becblue/H2_transmitter_PCB/3D图纸/导轨支架.png

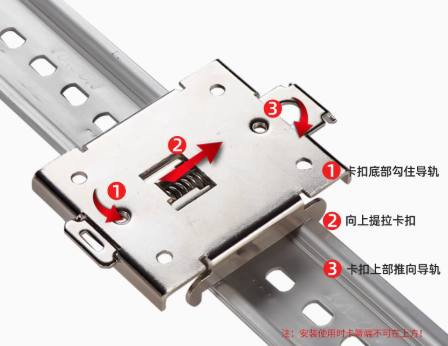
3D图纸/导轨支架.png
