becblue/H2_transmitter_PCB/壳体开孔图纸.png

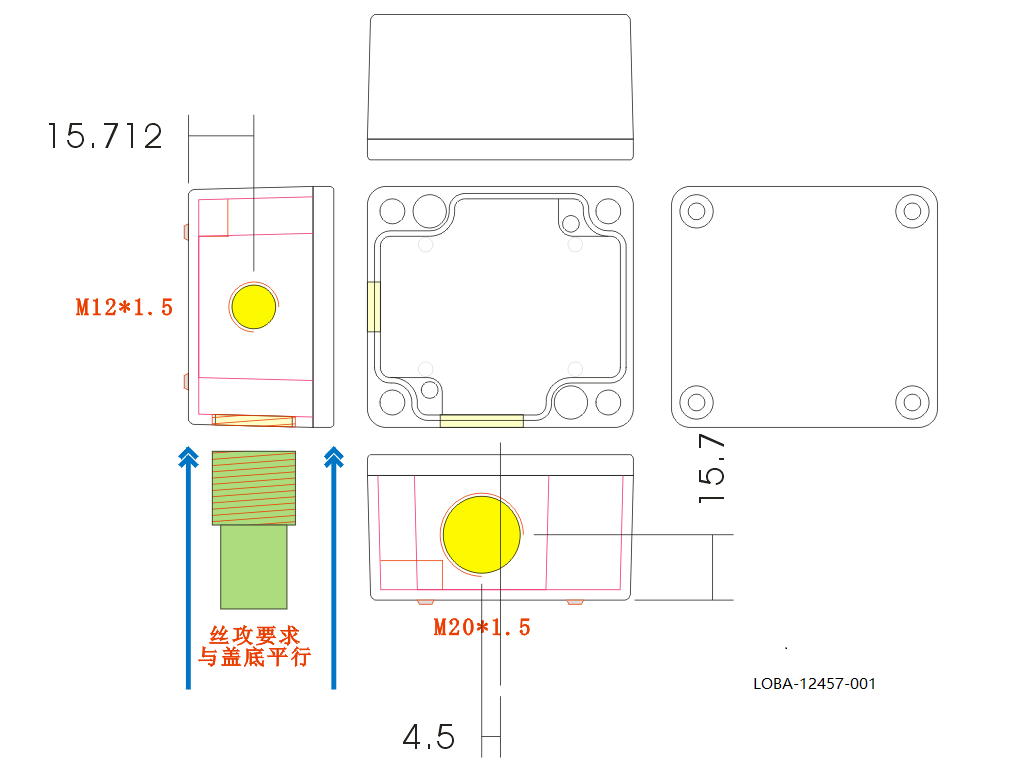
壳体开孔图纸.png
