becblue/H2_transmitter_PCB/PCB文件/嘉立创新建项目/氢气传感器（已标定）模块电路/BOM_Board1_PCB1_2025-02-27_v4.xlsx

Sheet: BOM_Board1_Schematic1_2025-02-2
No. | Quantity | Comment | Designator | Footprint | Value | Manufacturer Part | Manufacturer | Supplier Part | Supplier
1 | 4 | 100nF | C1,C5,C9,C11 | C0402 | 100nF | CC0402KRX7R9BB104 | YAGEO(国巨) | C131394 | LCSC
2 | 4 | 22uF | C2,C3,C12,C13 | C0805 | 22uF | CC0805MKX5R8BB226 | YAGEO(国巨) | C784585 | LCSC
3 | 4 | 10uF | C4,C10,C14,C15 | C0603 | 10uF | GRM188R6YA106MA73D | muRata(村田) | C194427 | LCSC
4 | 1 | 47uF | C6 | CAP-SMD_L7.3-W4.3-FD | 47uF | T491X476K035AT | KEMET(基美) | C87110 | LCSC
5 | 1 | 75pF | C7 | C0402 | 75pF | CC0402JRNPO9BN750 | YAGEO(国巨) | C107010 | LCSC
6 | 2 | 10uF | C8,C17 | CASE-C_6032 | 10uF | TAJC106K035RNJ | Kyocera AVX | C7211 | LCSC
7 | 1 | 100pF | C16 | C0402 | 100pF | CC0402KRX7R8BB101 | YAGEO(国巨) | C541383 | LCSC
8 | 1 | 10uF | C18 | C0603 | 10uF | HGC0603R5106M350NTHJ | Chinocera(华瓷) | C22367827 | LCSC
9 | 2 | 1nF | C19,C20 | C0603 | 1nF | CC0603KRX7R9BB102 | YAGEO(国巨) | C100040 | LCSC
10 | 1 | SS14 | D1 | SMA_L4.2-W2.6-LS5.3-RD |  | SS14 | MDD(辰达半导体) | C2480 | LCSC
11 | 1 | SMCJ24CAX | D2 | SMC_L6.9-W5.9-LS7.9-BI |  | SMCJ24CAX | 晶扬电子 | C3038088 | LCSC
12 | 2 | SS14 | D3,D4 | SMA_L4.3-W2.6-LS5.2-RD |  | SS14 | onsemi(安森美) | C83852 | LCSC
13 | 1 | SMBJ36CA | D5 | SMB_L4.6-W3.6-LS5.4-RD |  | SMBJ36CA | 宏嘉诚 | C19077589 | LCSC
14 | 1 | SMBJ12CA | D6 | SMB_L4.6-W3.6-LS5.4-RD |  | SMBJ12CA | 宏迦橙 | C19077566 | LCSC
15 | 2 | M7 | D7,D8 | SMA_L4.3-W2.6-LS5.0-FD |  | M7 | 宏迦橙 | C7420350 | LCSC
16 | 1 | 1N4148W | D9 | SOD-123_L2.7-W1.6-LS3.7-FD |  | 1N4148W | 宏迦橙 | C7420318 | LCSC
17 | 1 | BSMD1812-050-30V | F1 | F1812 |  | BSMD1812-050-30V | BHFUSE(佰宏) | C883141 | LCSC
18 | 1 | 10uH | L1 | IND-SMD_L4.4-W4.2 | 10uH | FXL0420-100-M | cjiang(长江微电) | C177242 | LCSC
19 | 1 | 4.7uH | L2 | IND-SMD_L7.0-W6.6 | 4.7uH | FXL0630-4R7-M | cjiang(长江微电) | C167220 | LCSC
20 | 1 | 15uH | L3 | IND-SMD_L4.0-W4.0 | 15uH | FHD4020S-150MT | cjiang(长江微电) | C602033 | LCSC
21 | 1 | SK2301AA | Q1 | SOT-23-3_L2.9-W1.6-P1.90-LS2.8-BR |  | SK2301AA | SHIKUES(时科) | C118316 | LCSC
22 | 1 | SS8050 | Q2 | SOT-23-3_L2.9-W1.3-P1.90-LS2.4-BR |  | SS8050 | 宏迦橙 | C7420370 | LCSC
23 | 2 | 49.9Ω | R1,R6 | R0402 | 49.9Ω | PTFR0402B49R9P9 | RESI(开步睿思) | C478876 | LCSC
24 | 2 | 511kΩ | R2,R7 | R0603 | 511kΩ | ARG03BTC5113 | Viking(光颉) | C2684557 | LCSC
25 | 2 | 105kΩ | R3,R12 | R0402 | 105kΩ | RT0402BRD07105KL | YAGEO(国巨) | C852475 | LCSC
26 | 3 | 100kΩ | R4,R10,R11 | R0402 | 100kΩ | RT0402BRD07100KL | YAGEO(国巨) | C852472 | LCSC
27 | 1 | 13.3kΩ | R5 | R0603 | 13.3kΩ | RT0603BRD0713K3L | YAGEO(国巨) | C861117 | LCSC
28 | 2 | 27kΩ | R8,R15 | R0603 | 27kΩ | RT0603BRE0727KL | YAGEO(国巨) | C326751 | LCSC
29 | 2 | 2kΩ | R9,R26 | R0603 | 2kΩ | RT0603BRD072KL | YAGEO(国巨) | C728588 | LCSC
30 | 1 | 5.23kΩ | R13 | R0603 | 5.23kΩ | RT0603BRD075K23L | YAGEO(国巨) | C861485 | LCSC
31 | 3 | 10kΩ | R14,R20,R25 | R0603 | 10kΩ | RT0603BRD0710KL | YAGEO(国巨) | C95204 | LCSC
32 | 2 | 0Ω | R16,R24 | R0603 | 0Ω | RC0603FR-070RL | YAGEO(国巨) | C100044 | LCSC
33 | 1 | 100kΩ | R17 | R0603 | 100kΩ | RT0603BRD07100KL | YAGEO(国巨) | C122538 | LCSC
34 | 2 | 47Ω | R18,R19 | R0603 | 47Ω | RT0603BRE0747RL | YAGEO(国巨) | C705861 | LCSC
35 | 1 | 470Ω | R21 | R0603 | 470Ω | AR03BTC4700 | Viking(光颉) | C374403 | LCSC
36 | 2 | 200Ω | R22,R23 | R0603 | 200Ω | RT0603BRD07200RL | YAGEO(国巨) | C861216 | LCSC
37 | 2 | M4螺丝 | SCREW1,SCREW2 | M4螺丝
38 | 2 | TPS54302DDCR | U1,U2 | SOT-23-6_L2.9-W1.6-P0.95-LS2.8-BL |  | TPS54302DDCR | TI(德州仪器) | C311983 | LCSC
39 | 1 | MP2359DJ-LF-Z | U3 | SOT-23-6_L2.9-W1.6-P0.95-LS2.8-BR |  | MP2359DJ-LF-Z | MPS(芯源) | C14259 | LCSC
40 | 1 | TP2274-SR | U4 | SOIC-14_L8.7-W3.9-P1.27-LS6.0-BL |  | TP2274-SR | 3PEAK | C95870 | LCSC
41 | 1 | LZ8V-2.54-6P | U5 | LC8+LZ8V-2.54 5PIN
42 | 1 | ZX-XH2.54-5PZZ | U6 | CONN-TH_5P-P2.50_ZX-XH2.54-5PZZ |  | ZX-XH2.54-5PZZ | Megastar(兆星) | C7429635 | LCSC
43 | 1 | XY-XHB2.54-2A11 | U7 | HDR-TH_2P-P2.50-V-F-1 |  | XY-XHB2.54-2A11 | XYECONN(辛译) | C19271386 | LCSC

Sheet: Sheet1
1 | C6 | 分配立创编号 | C87110 | LCSC |  | 47uF | CAP-SMD_L7.3-W4.3-FD | 1 | T491X476K035AT | KEMET(基美) | ...
 | 2 | C7 | 分配立创编号 | C107010 | LCSC |  | 75pF | C0402 | 1 | CC0402JRNPO9BN750 | YAGEO(国巨) | ...
 | 3 | C1, | 分配立创编号 | C131394 | LCSC |  | 100nF | C0402 | 4 | CC0402KRX7R9BB104 | YAGEO(国巨) | ...
 |  | C5,
 |  | C9,
 |  | C11
 | 4 | C2, | 分配立创编号 | C784585 | LCSC |  | 22uF | C0805 | 4 | CC0805MKX5R8BB226 | YAGEO(国巨) | ...
 |  | C3,
 |  | C12,
 |  | C13
 | 5 | C4, | 分配立创编号 | C194427 | LCSC |  | 10uF | C0603 | 4 | GRM188R6YA106MA73D | muRata(村田) | ...
 |  | C10,
 |  | C14,
 |  | C15
 | 6 | C16 | 分配立创编号 | C541383 | LCSC |  | 100pF | C0402 | 1 | CC0402KRX7R8BB101 | YAGEO(国巨) | ...
 | 7 | C8, | 分配立创编号 | C7211 | LCSC |  | 10uF | CASE-C_6032 | 2 | TAJC106K035RNJ | Kyocera AVX | ...
 |  | C17
 | 8 | C18 | 分配立创编号 | C22367827 | LCSC |  | 10uF | C0603 | 1 | HGC0603R5106M350NTHJ | Chinocera(华瓷) | ...
 | 9 | C19, | 分配立创编号 | C100040 | LCSC |  | 1nF | C0603 | 2 | CC0603KRX7R9BB102 | YAGEO(国巨) | ...
 |  | C20
 | 10 | D1 | 分配立创编号 | C2480 | LCSC |  | SS14 | SMA_L4.2-W2.6-LS5.3-RD | 1 | SS14 | MDD(辰达半导体) | ...
 | 11 | D2 | 分配立创编号 | C3038088 | LCSC |  | SMCJ24CAX | SMC_L6.9-W5.9-LS7.9-BI | 1 | SMCJ24CAX | 晶扬电子 | ...
 | 12 | D3, | 分配立创编号 | C83852 | LCSC |  | SS14 | SMA_L4.3-W2.6-LS5.2-RD | 2 | SS14 | onsemi(安森美) | ...
 |  | D4
 | 13 | D5 | 分配立创编号 | C19077589 | LCSC |  | SMBJ36CA | SMB_L4.6-W3.6-LS5.4-RD | 1 | SMBJ36CA | 宏嘉诚 | ...
 | 14 | D6 | 分配立创编号 | C19077566 | LCSC |  | SMBJ12CA | SMB_L4.6-W3.6-LS5.4-RD | 1 | SMBJ12CA | 宏迦橙 | ...
 | 15 | D7, | 分配立创编号 | C7420350 | LCSC |  | M7 | SMA_L4.3-W2.6-LS5.0-FD | 2 | M7 | 宏迦橙 | ...
 |  | D8
 | 16 | D9 | 分配立创编号 | C7420318 | LCSC |  | 1N4148W | SOD-123_L2.7-W1.6-LS3.7-FD | 1 | 1N4148W | 宏迦橙 | ...
 | 17 | F1 | 分配立创编号 | C883141 | LCSC |  | BSMD1812-050-30V | F1812 | 1 | BSMD1812-050-30V | BHFUSE(佰宏) | ...
 | 18 | L1 | 分配立创编号 | C177242 | LCSC |  | 10uH | IND-SMD_L4.4-W4.2 | 1 | FXL0420-100-M | cjiang(长江微电) | ...
 | 19 | L2 | 分配立创编号 | C167220 | LCSC |  | 4.7uH | IND-SMD_L7.0-W6.6 | 1 | FXL0630-4R7-M | cjiang(长江微电) | ...
 | 20 | L3 | 分配立创编号 | C602033 | LCSC |  | 15uH | IND-SMD_L4.0-W4.0 | 1 | FHD4020S-150MT | cjiang(长江微电) | ...
 | 21 | Q1 | 分配立创编号 | C118316 | LCSC |  | SK2301AA | SOT-23-3_L2.9-W1.6-P1.90-LS2.8-BR | 1 | SK2301AA | SHIKUES(时科) | ...
 | 22 | Q2 | 分配立创编号 | C7420370 | LCSC |  | SS8050 | SOT-23-3_L2.9-W1.3-P1.90-LS2.4-BR | 1 | SS8050 | 宏迦橙 | ...
