becblue/H2_transmitter_PCB/PCB文件/DARXT/DARXT.xls

序号 | 物料名称 | 丝印 | 型号 |  | 封装 | 品牌 | 位号 | 数量 | 备注 | 正面图片 | 反面图片
1 | 贴片元器件
2 | 贴片电阻 | 103 | 10K | 5% | 0603 |  | R9 R14 R16 | 3
3 | 贴片电阻 | 104 | 100K | 5% | 0603 |  | R1 R4 R18 | 3
4 | 贴片电阻 | 201 | 200R | 5% | 0603 |  | R11 R12 | 2
5 | 贴片电阻 | 202 | 2K | 5% | 0603 |  | R6 R13 | 2
6 | 贴片电阻 | 273 | 27K | 5% | 0603 |  | R5 R15 | 2
7 | 贴片电阻 | 470 | 47R | 5% | 0603 |  | R7 R8 | 2
8 | 贴片电阻 | 471 | 470R | 5% | 0603 |  | R10 | 1
9 | 贴片电阻 | 473 | 47K | 5% | 0603 |  | R2 | 1
10 | 贴片电阻 | 912 | 9.1K | 5% | 0603 |  | R3 | 1
11 | 贴片电容 |  | 1NF | 10% | 0603 |  | C9 C10 | 2
12 | 贴片电容 |  | 100NF | 10% | 0603 |  | C1 C5 | 2
13 | 贴片电容 |  | 10UF | 20% | 1206 |  | C2 C3 C4 C6 C7 C8 | 6
14 | 一体成型电感 | 4R7 | FXL0630-4R7-M |  | 0630 | cjiang(长江微电) | L1 L2 | 2
15 | 通用二极管 | M7 | M7 |  | DO-214AC | MDD(辰达半导体) | D3 D4 | 2
16 | 肖特基二极管 | SS14 | SS14 |  | DO-214AC | MDD(辰达半导体) | D1 D7 D8 | 3
17 | 开关二极管 | T4 | 1N4148W |  | SOD-123 | 宏迦橙 | D5 | 1
18 | TVS/ESD二极管 | BE | SMBJ12CA |  | DO-214AA | 宏迦橙 | D6 | 1
19 | TVS/ESD二极管 | CP | SMBJ36CA |  | DO-214AA | 宏迦橙 | D2 | 1
20 | NPN | J3Y | S8050 |  | SOT-23 | 宏迦橙 | Q2 | 1
21 | P-MOS | A1SHB | SK2301AA |  | SOT-23 | SHIKUES(时科) | Q1 | 1
22 | IC | TP2274 | TP2274-SR |  | SOP-14 | 3PEAK(思瑞浦) | U3 | 1
23 | IC | IF8NN | MP2359DJ-LF-Z |  | SOT23-6 | MPS(芯源) | U1 U2 | 2
24 | 插件元器件
25 | 插拔式弯针座 |  | DB2ER-5.08-4P-GN |  | SIP-4 | DORABO(地博电气) | P3 | 1
26 | 插拔式接线端子 |  | DB2EK-5.08-4P-GN-S |  | SIP-4 | DORABO(地博电气) |  | 1
27 | 测试插孔 |  | 参考实物 |  | SIP-1 |  | P2 | 5 | https://item.taobao.com/item.htm?id=781619027857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 | =DISPIMG("ID_7849768306F9491B9268AB8A7467ACBD",1)
