becblue/H2_transmitter_PCB/3D图纸/传感器插座板.step.SLDASM

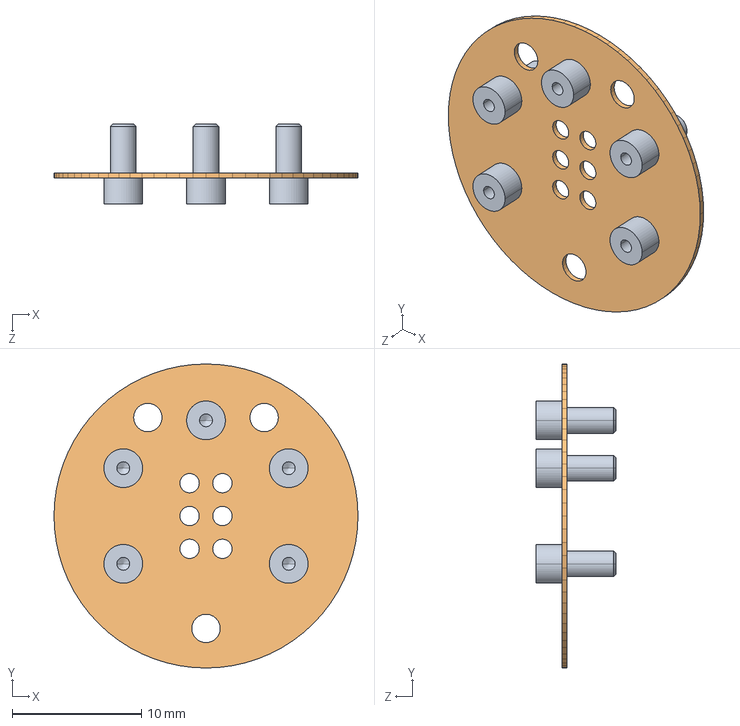
[picture p10: CAD file, 2025-04-16]
3D图纸/传感器插座板.step.SLDASM
23.5 x 23.5 x 6.20 mm
__________^JP2_传感器插座板.step x 5
Board.step
