becblue/H2_transmitter_PCB/3D图纸/气体传感器.SLDPRT

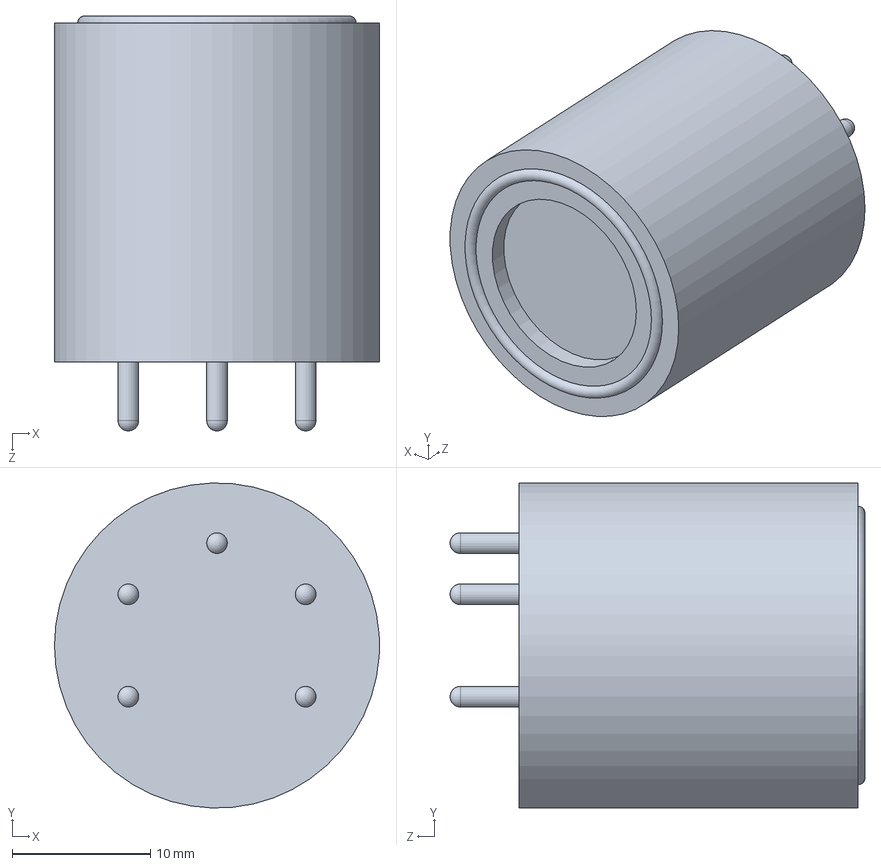
[picture p11: CAD file, 2025-04-16]
3D图纸/气体传感器.SLDPRT
23.5 x 23.5 x 30.0 mm
