becblue/H2_transmitter_PCB/PCB文件/嘉立创新建项目/氢气传感器（已标定）模块电路/DXF_PCB1_2025-02-26_AutoCAD2007.dxf

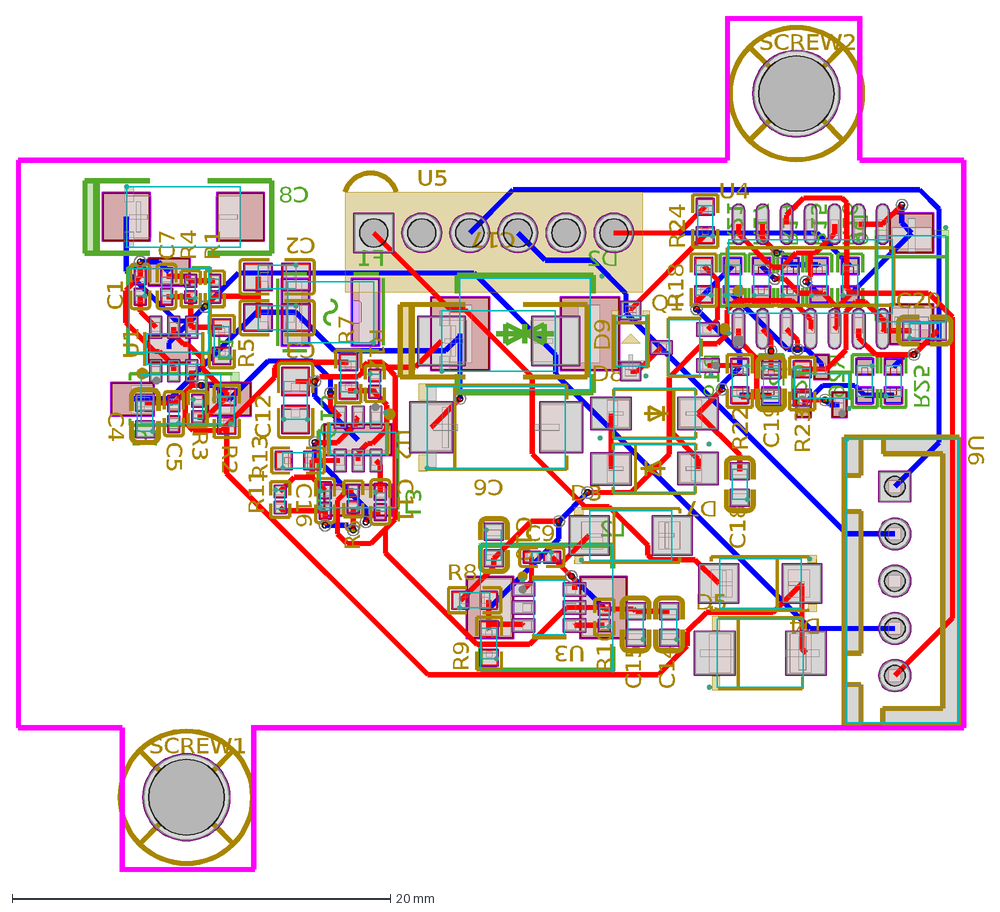
[picture p12: CAD file, 2025-04-16]
PCB文件/嘉立创新建项目/氢气传感器（已标定）模块电路/DXF_PCB1_2025-02-26_AutoCAD2007.dxf
C8
C13
D1
D2
F1
L1
L3
Q2
R19
R20
R25
R21
R26
D6
L2
R14
R15
R16
R17
C1
C2
C3
C4
C5
C6
C7
C11
C12
C16
C17
C19
C20
C18
D8
D7
D9
Q1
R1
R2
R3
R4
R5
R6
R7
R11
R12
R13
R22
R18
R23
U1
U2
U6
U5
U4
C9
C10
C14
C15
D3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
