becblue/H2_transmitter_PCB/3D图纸/传感器顶盖.SLDPRT

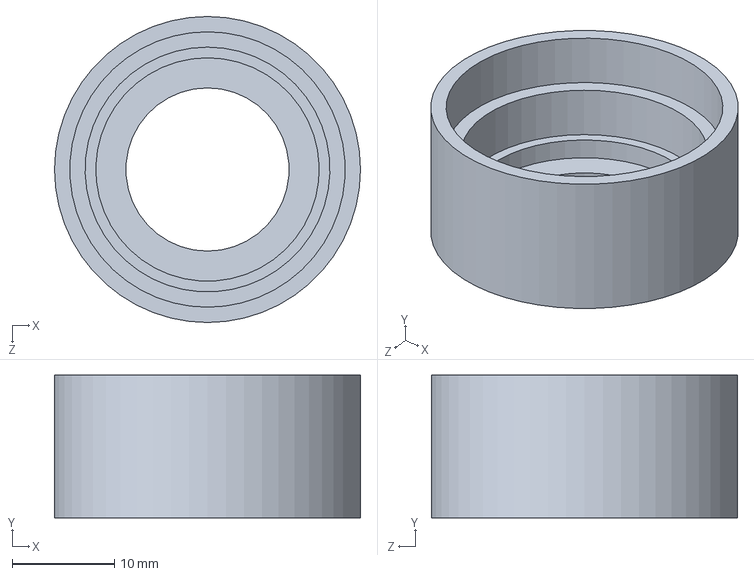
[picture p13: CAD file, 2025-04-16]
3D图纸/传感器顶盖.SLDPRT
30.0 x 14.0 x 30.0 mm
