becblue/H2_transmitter_PCB/3D图纸/六角螺柱.SLDPRT

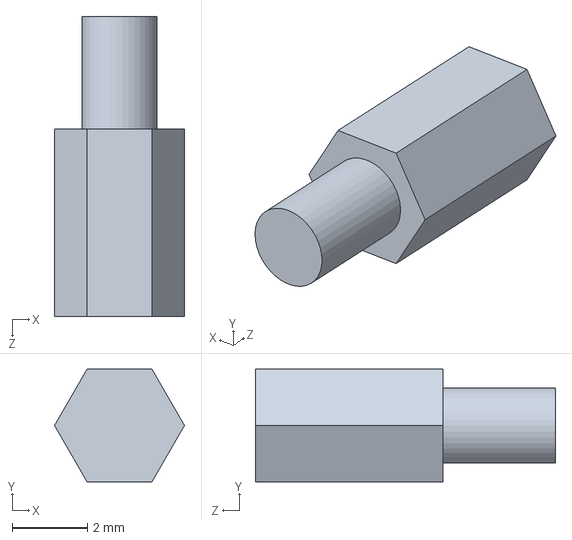
[picture p14: CAD file, 2025-04-16]
3D图纸/六角螺柱.SLDPRT
3.46 x 3.00 x 8.00 mm
