becblue/H2_transmitter_PCB/3D图纸/装配体1.STEP

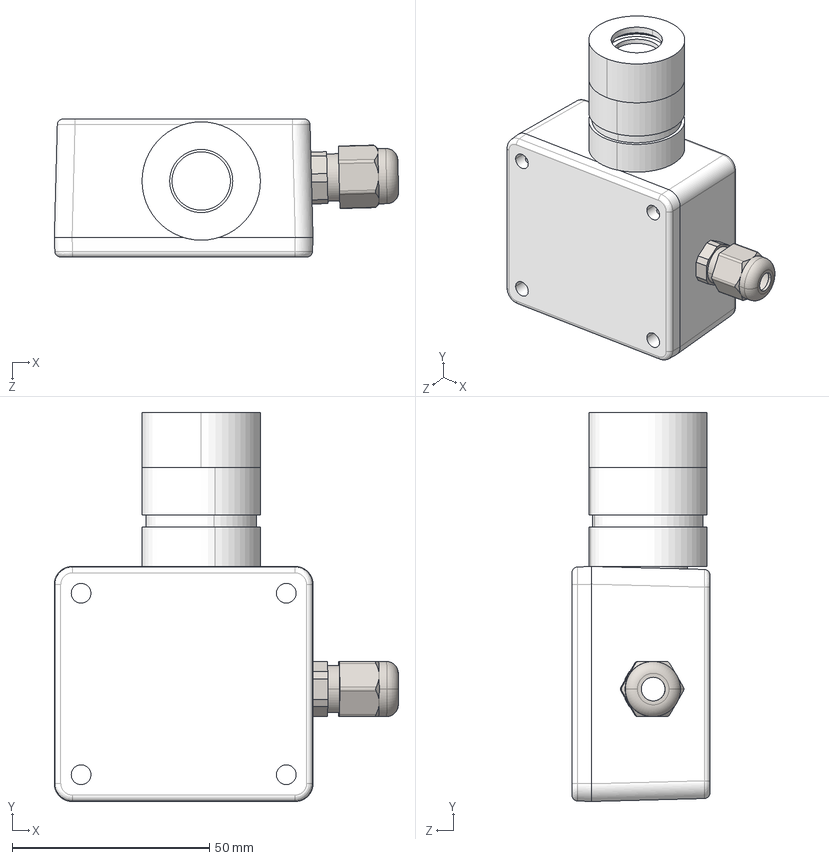
[picture p15: CAD file, 2025-04-16]
3D图纸/装配体1.STEP
87.3 x 98.6 x 35.0 mm
褲极
ァ极換覜ん
奻裔
传感器顶盖
传感器外壳
M12
