becblue/H2_transmitter_PCB/3D图纸/标定探头.SLDPRT

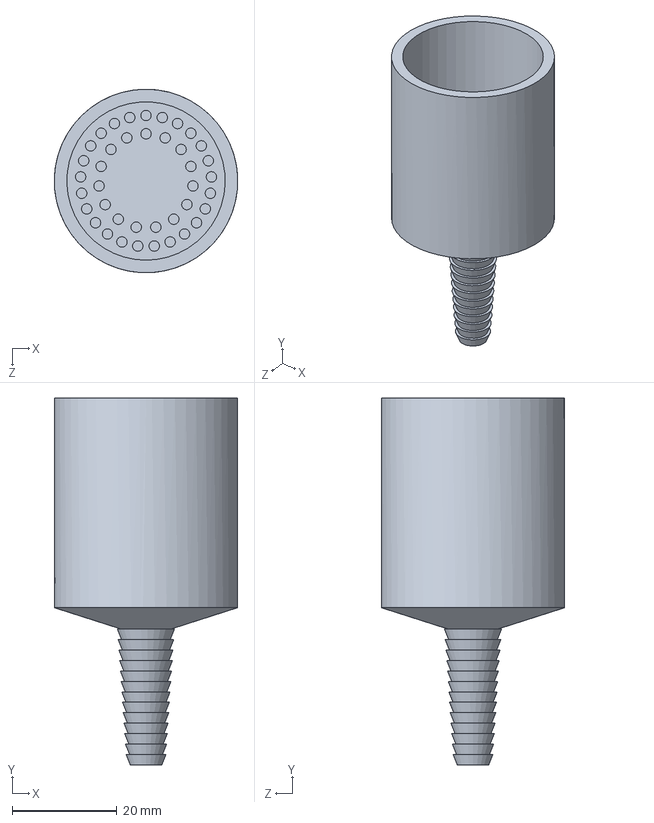
[picture p16: CAD file, 2025-04-16]
3D图纸/标定探头.SLDPRT
35.0 x 70.0 x 35.0 mm
