becblue/H2_transmitter_PCB/3D图纸/壳体.STEP

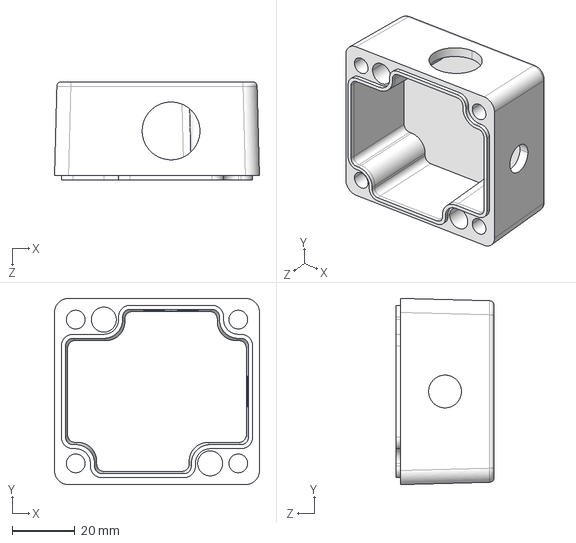
[picture p17: CAD file, 2025-04-16]
3D图纸/壳体.STEP
65.6 x 59.6 x 31.5 mm
