becblue/H2_transmitter_PCB/3D图纸/上盖.SLDPRT

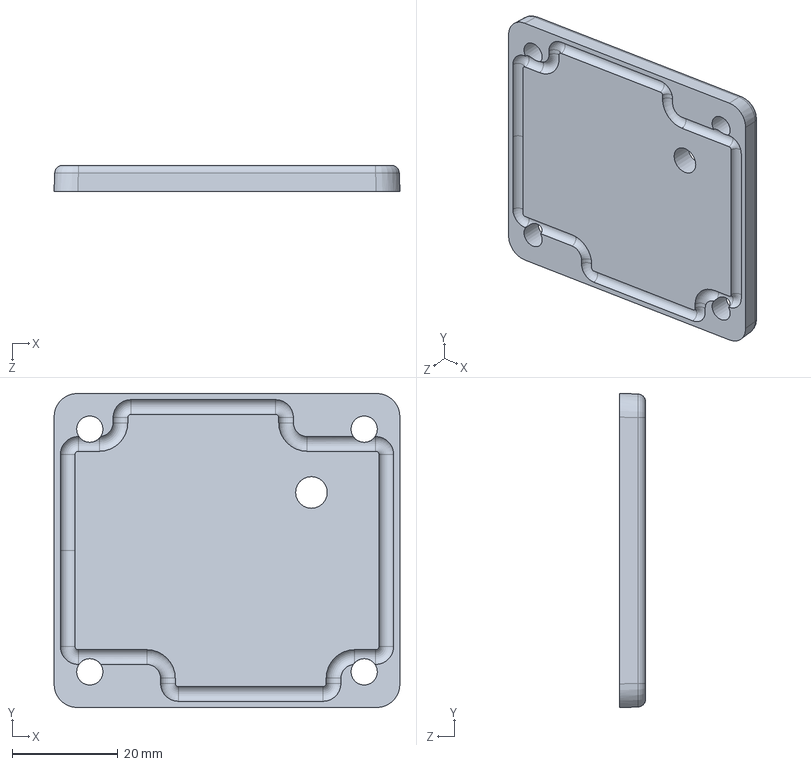
[picture p18: CAD file, 2025-04-16]
3D图纸/上盖.SLDPRT
65.6 x 59.6 x 5.00 mm
