becblue/H2_transmitter_PCB/3D图纸/传感器插座.STEP

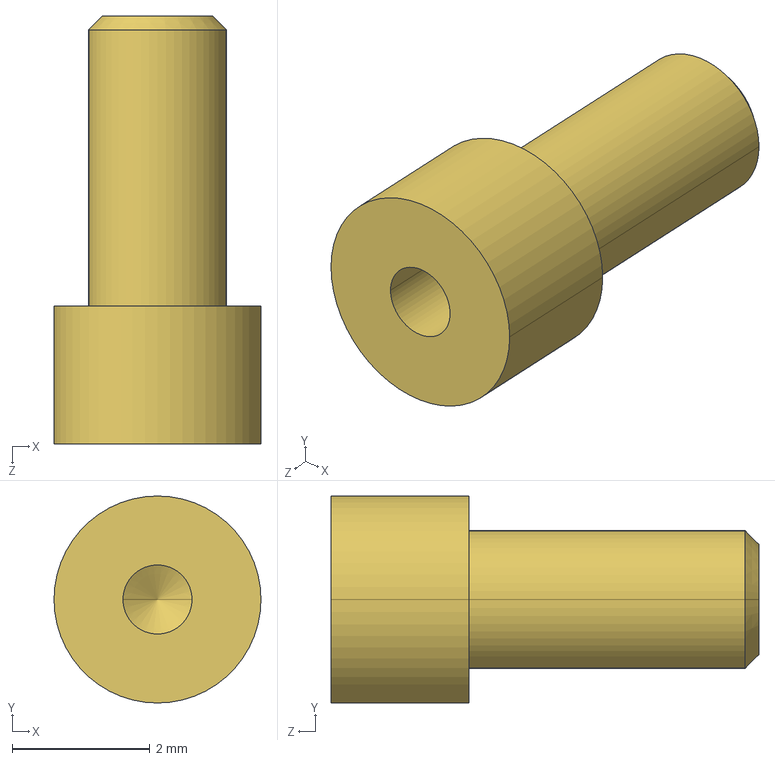
[picture p19: CAD file, 2025-04-16]
3D图纸/传感器插座.STEP
3.00 x 3.00 x 6.20 mm
