becblue/H2_transmitter_PCB/3D图纸/传感器外壳.SLDPRT

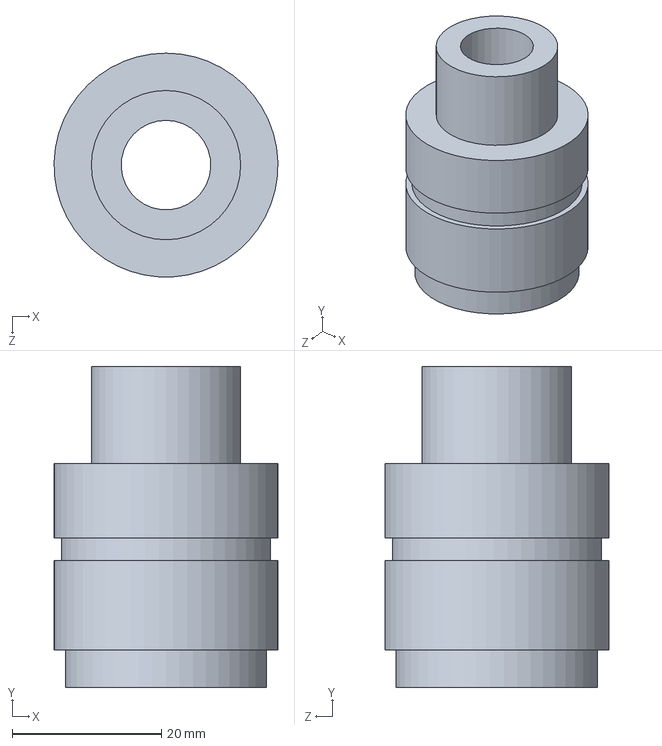
[picture p20: CAD file, 2025-04-16]
3D图纸/传感器外壳.SLDPRT
30.0 x 43.0 x 30.0 mm
