becblue/H2_transmitter_PCB/(list of files, cad)

Other CAD files:
3D图纸/传感器插座板/JP2.step.SLDASM
3D图纸/Board.step.SLDPRT
3D图纸/传感器插座板/传感器插座板.step
3D图纸/传感器插座板/__________.step.SLDPRT
3D图纸/传感器电路板.DWG
3D图纸/FA1底(1).dwg
3D图纸/NVXH-TopTrack.SLDPRT
3D图纸/上盖丝印.DWG
3D图纸/FA1盖(1).dwg
3D图纸/NVXH-TopTrack.STL
3D图纸/传感器插座.SLDPRT
3D图纸/传感器插座板/传感器插座板.SLDASM
3D图纸/壳体.SLDPRT
3D图纸/标定探头.STL
3D图纸/装配体1.DWG
3D图纸/装配体1.SLDDRW
3D图纸/铸铝盒体.SLDDRW
