becblue/H2_transmitter_PCB/调试命令.xlsx

 | FF 01 07 01
问询模式 | 主站发送 | 接收翻译器
 | 主站接收 |  |  | FF 01 03 02 0B 18 BF 7E
 |  | 1 | 地址码 | 01
 |  | 2 | 功能码 | 03
 |  | 3 | 有效字节数 | 02
 |  | 4 | 气体浓度值 | 0B | 11 | 284
 |  | 5 |  | 18 | 24
 |  | 6 | 校验码低位 | BF
 |  | 7 | 校验码高位 | 7E
 |  | 8
 |  | 9
 |  | 10
 |  | 11 |  |  |  |  | Rx:000299-01 03 02 0B 18 BF 7E
 |  | 12
 |  | 13
 |  | 14
 |  | 15
 |  | 16
