becblue/H2_transmitter_PCB/PCB文件/嘉立创新建项目/氢气传感器（已标定）模块电路/SCH_Schematic1_2025-02-25.pdf

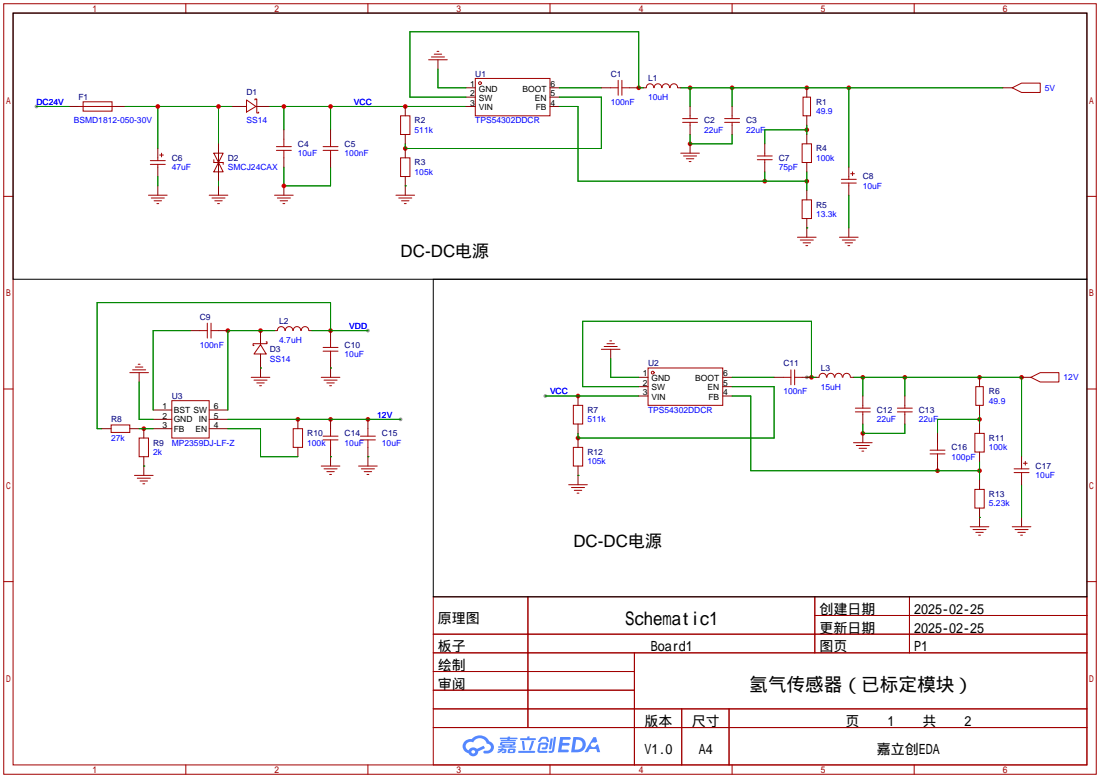
[picture p21: page 1]

原理图 | Schematic1 | 创建日期 | 2025-02-25

更新日期 | 2025-02-25

板子 | Board1 | 图页 | P1
绘制 | | 氢气传感器（已标定模块）
审阅

V1.0 | A4 | 嘉立创EDA

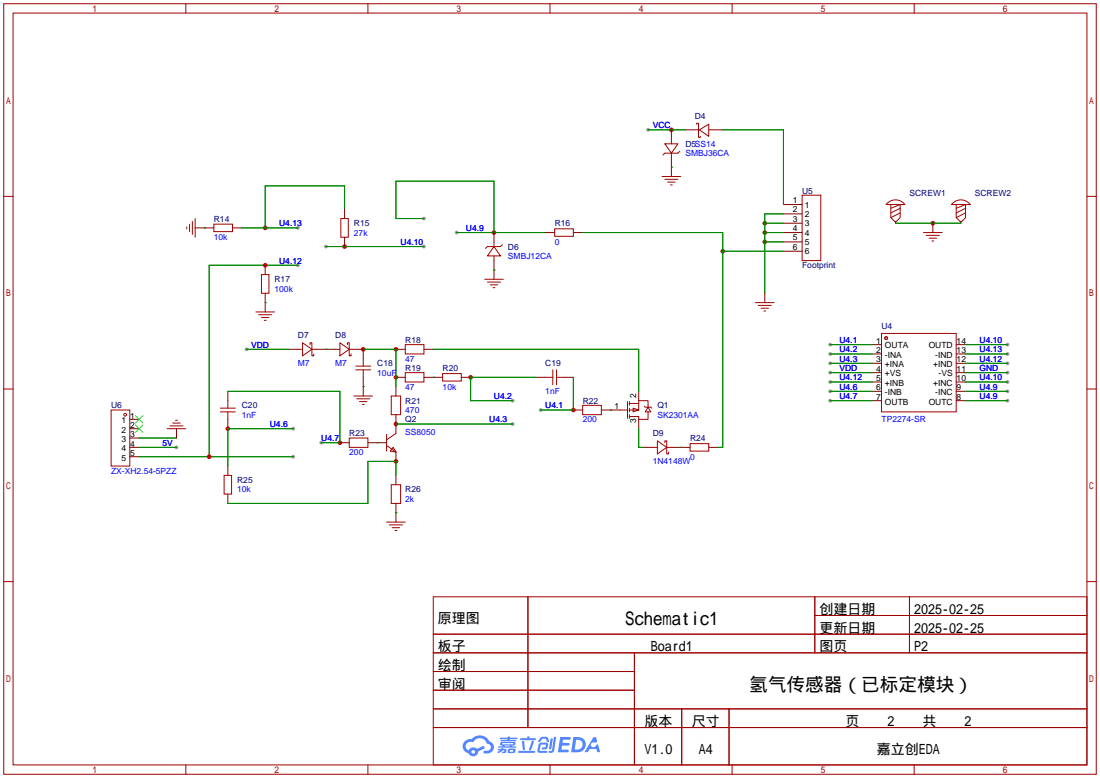
[picture p22: page 2]

+INC 10 -VS 11 +IND 12 -IND 13 OUTD 14

原理图 | Schematic1 | 创建日期 | 2025-02-25

更新日期 | 2025-02-25

板子 | Board1 | 图页 | P2
绘制 | | 氢气传感器（已标定模块）
审阅

V1.0 | A4 | 嘉立创EDA
