becblue/H2_transmitter_PCB/QT-3.pdf

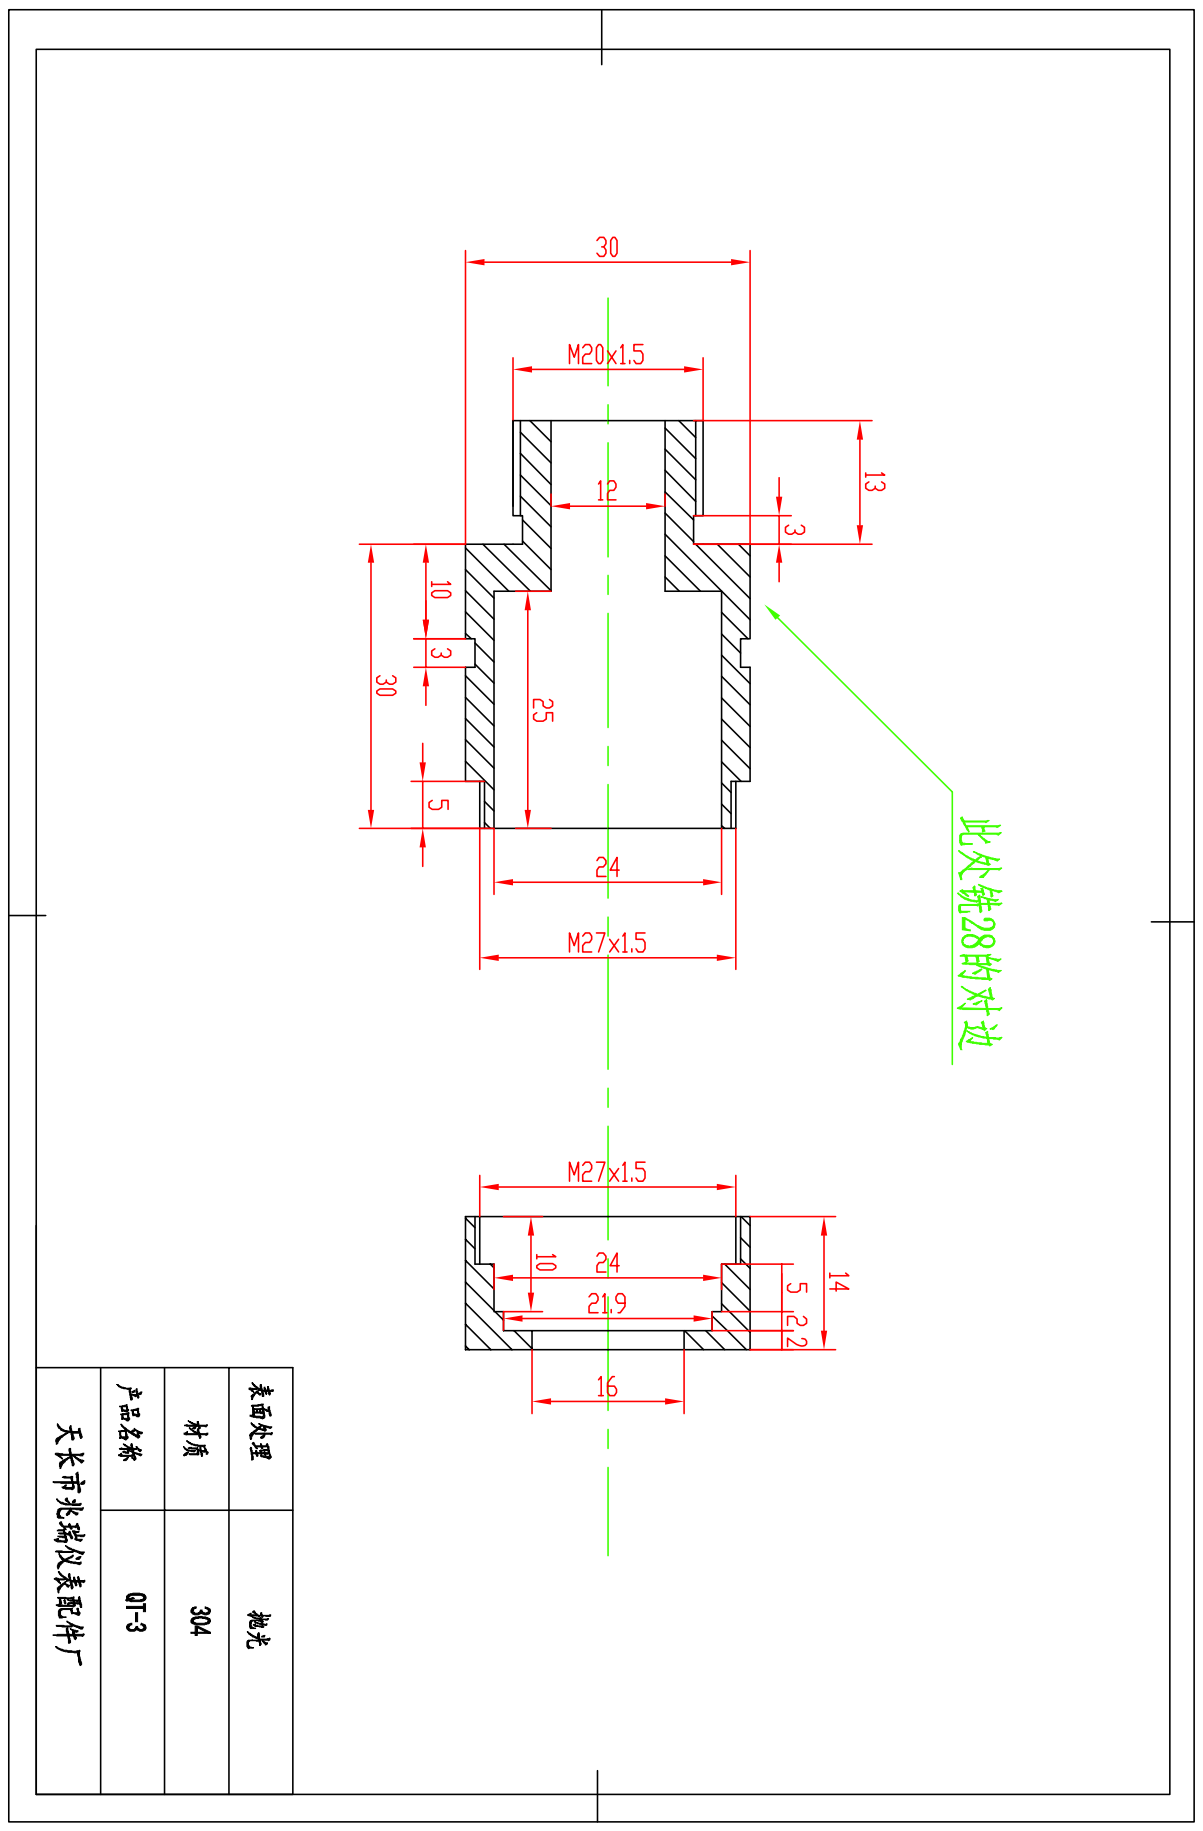
[picture p23: page 1]
