becblue/H2_transmitter_PCB/QT-3JC.pdf

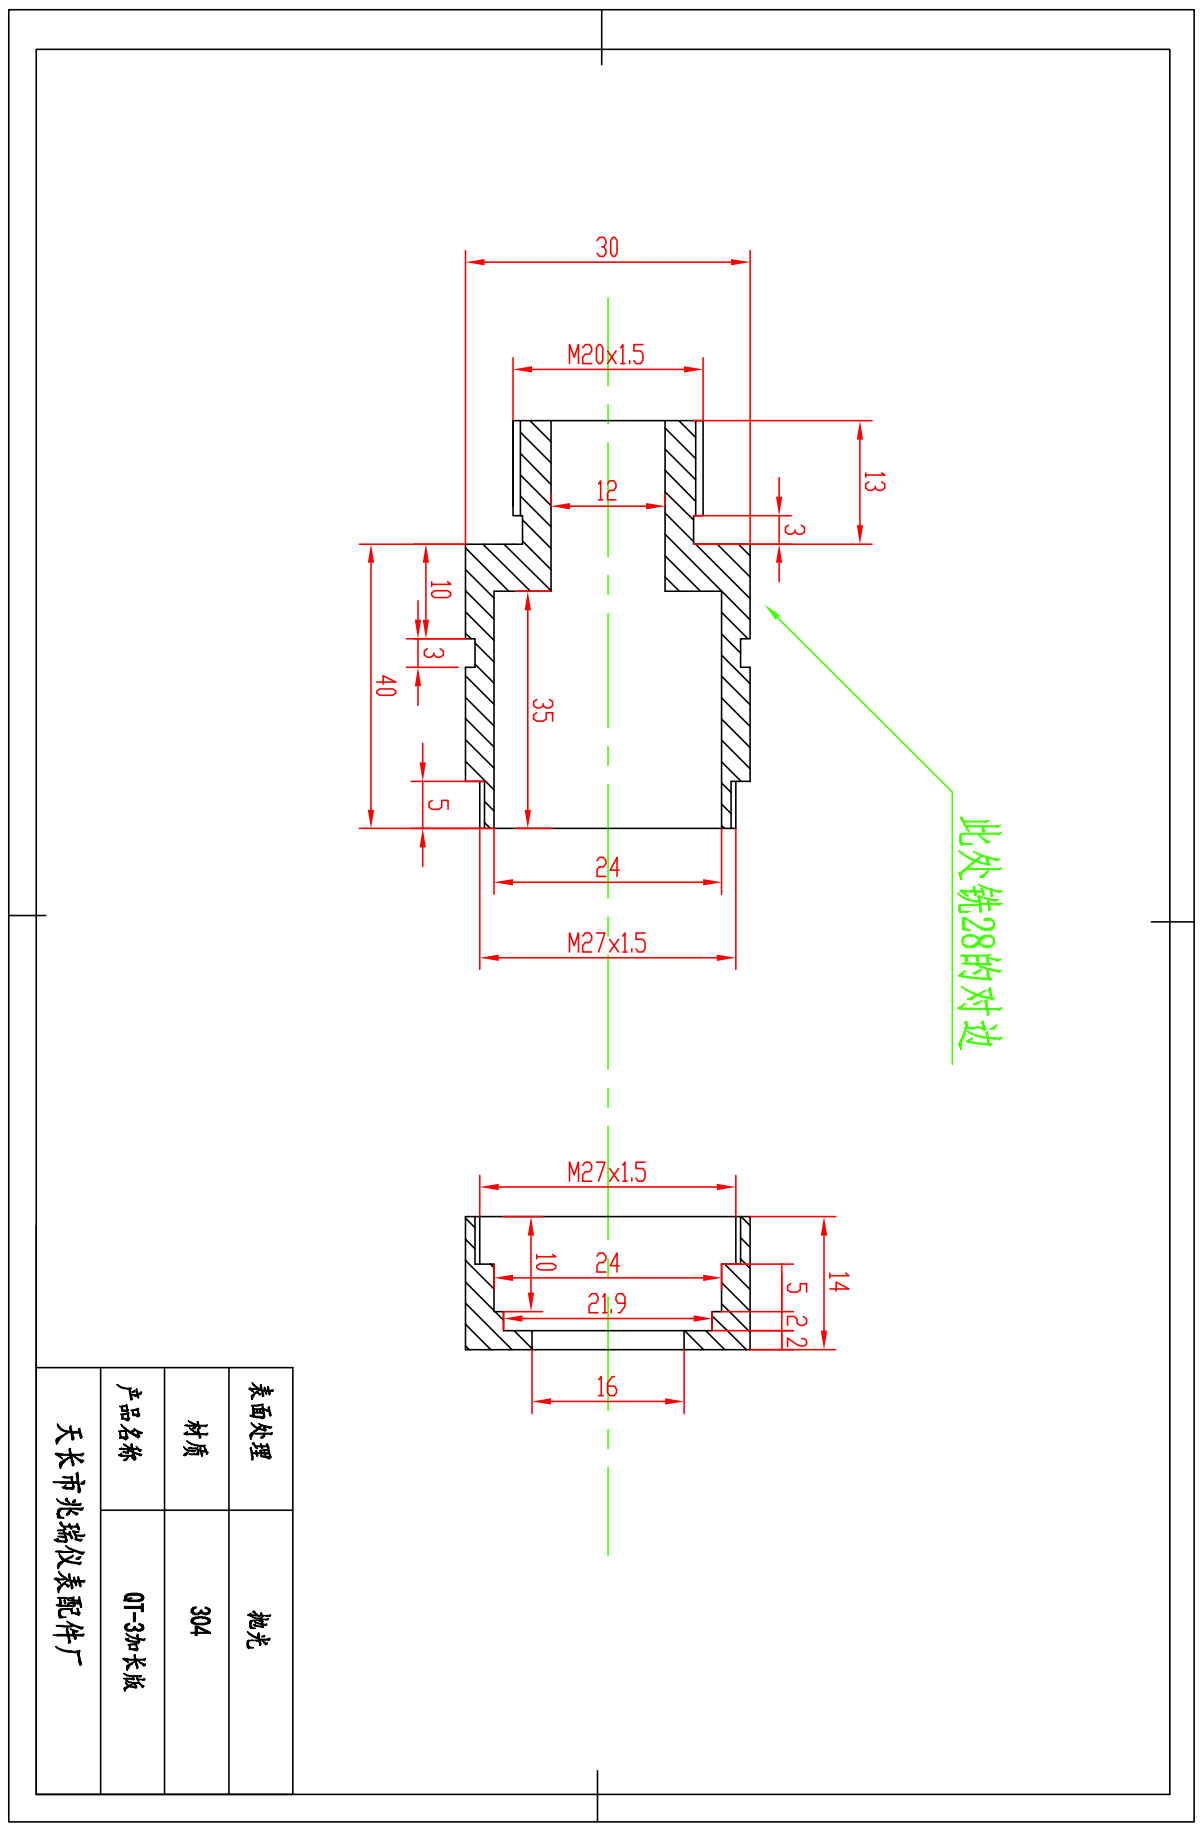
[picture p24: page 1]
