becblue/H2_transmitter_PCB/QT-3jc细牙加长防爆版.pdf

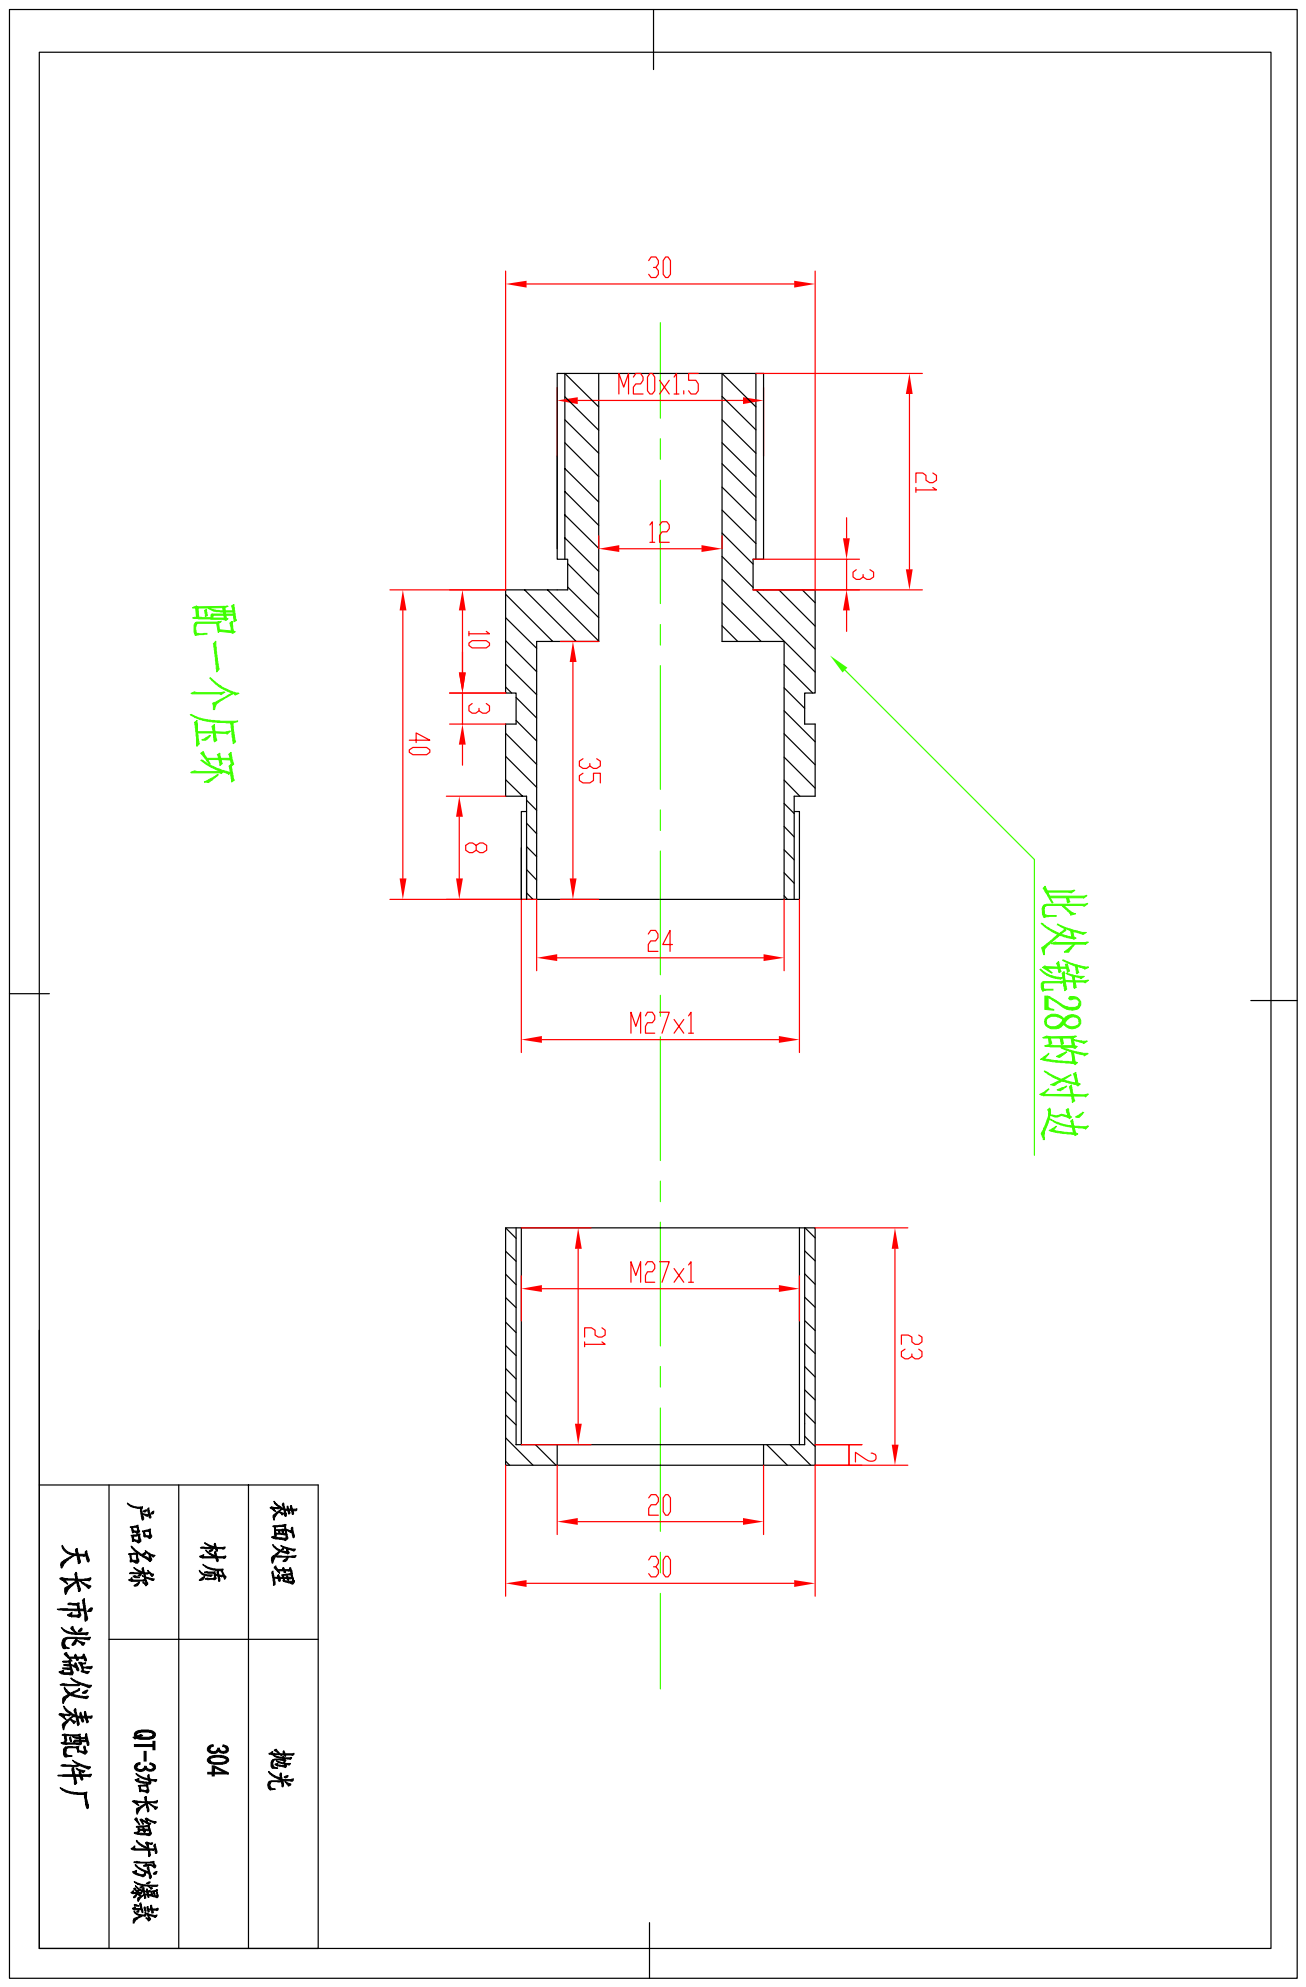
[picture p25: page 1]
