becblue/H2_transmitter_PCB/3D图纸/FA1底(1) Model (1).pdf

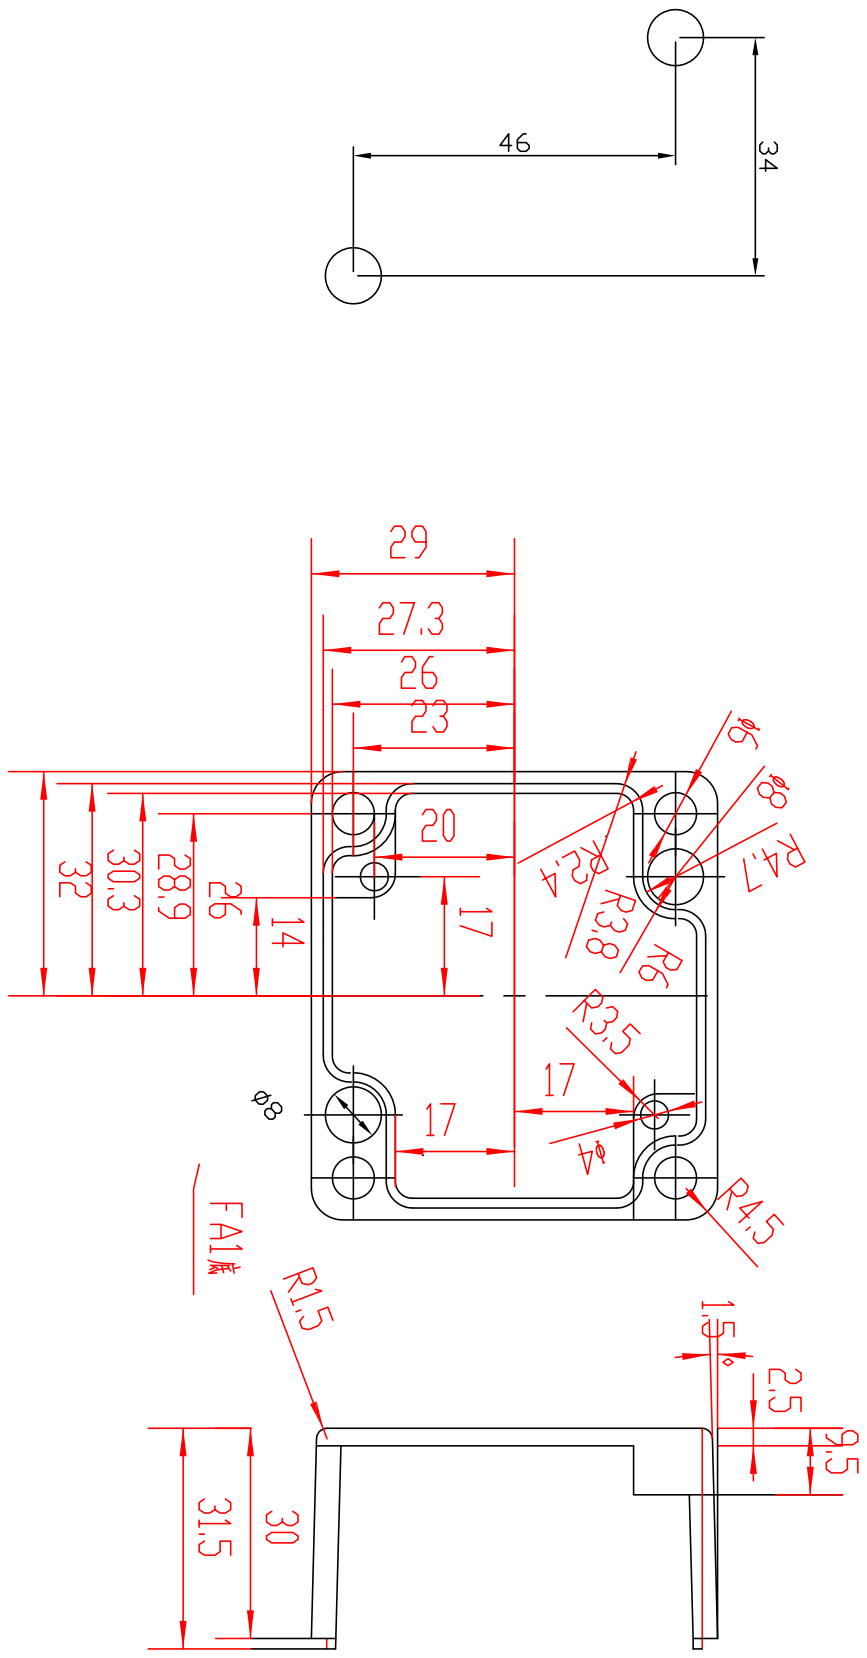
[picture p26: page 1]
