becblue/H2_transmitter_PCB/3D图纸/上盖丝印 Model (1).pdf

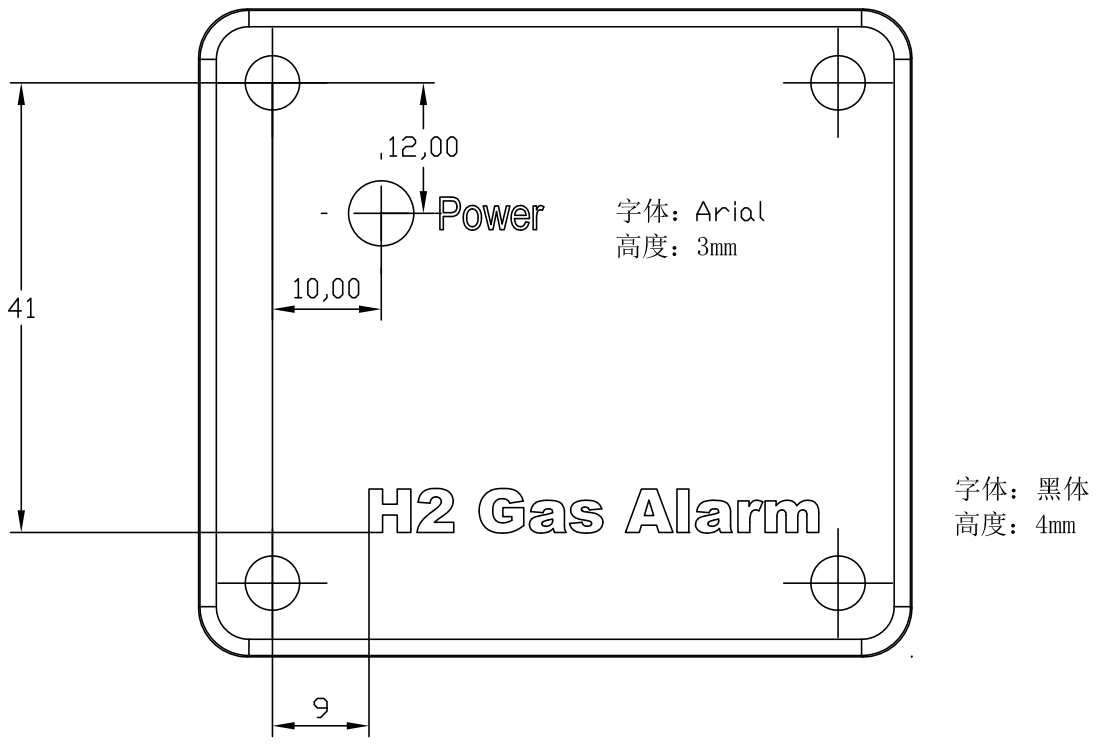
[picture p27: page 1]
