becblue/H2_transmitter_PCB/PCB文件/DARXT/DARXT-PCB.pdf

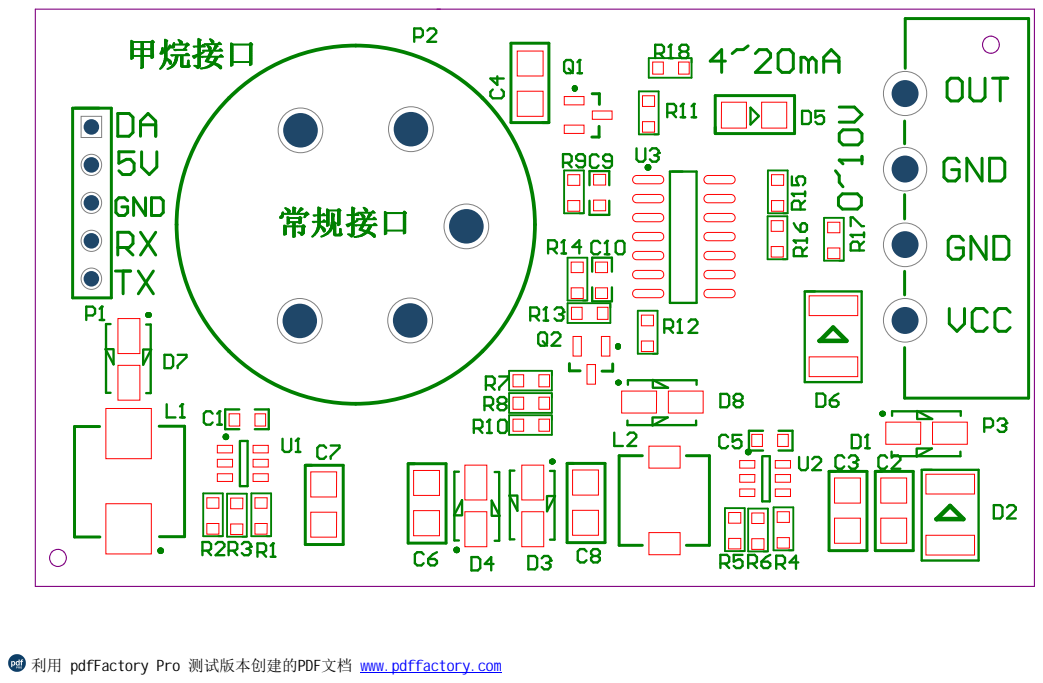
[picture p28: page 1]

利用 pdfFactory Pro 测试版本创建的PDF文档 www.pdffactory.com

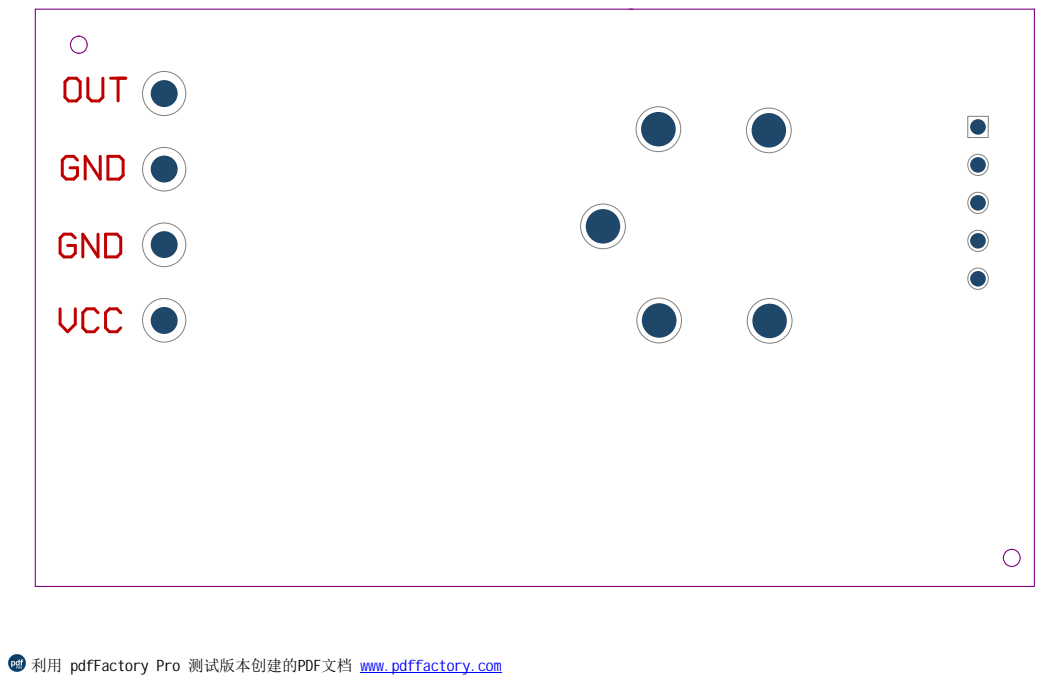
[picture p29: page 2]

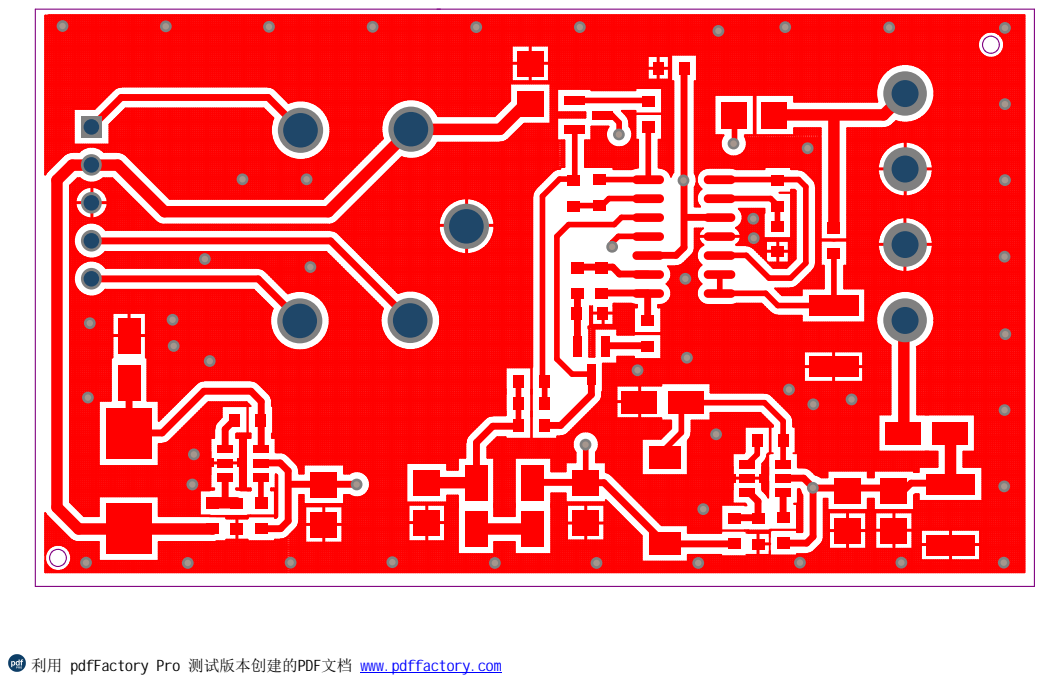
[picture p30: page 3]

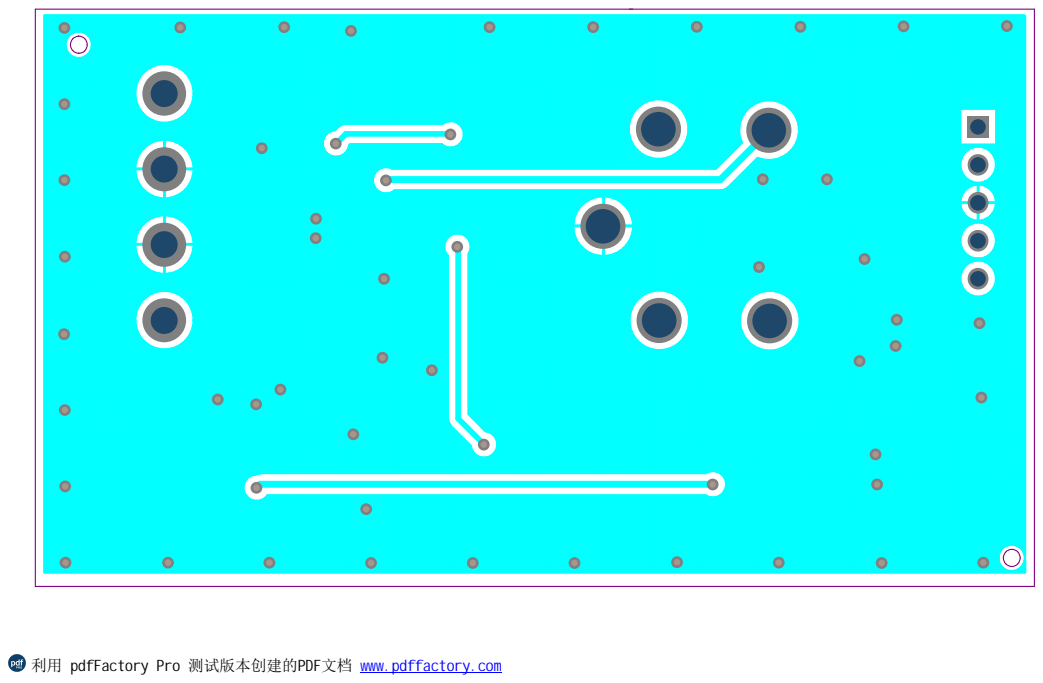
[picture p31: page 4]
