becblue/H2_transmitter_PCB/PCB文件/DARXT/DARXT-SCH.pdf

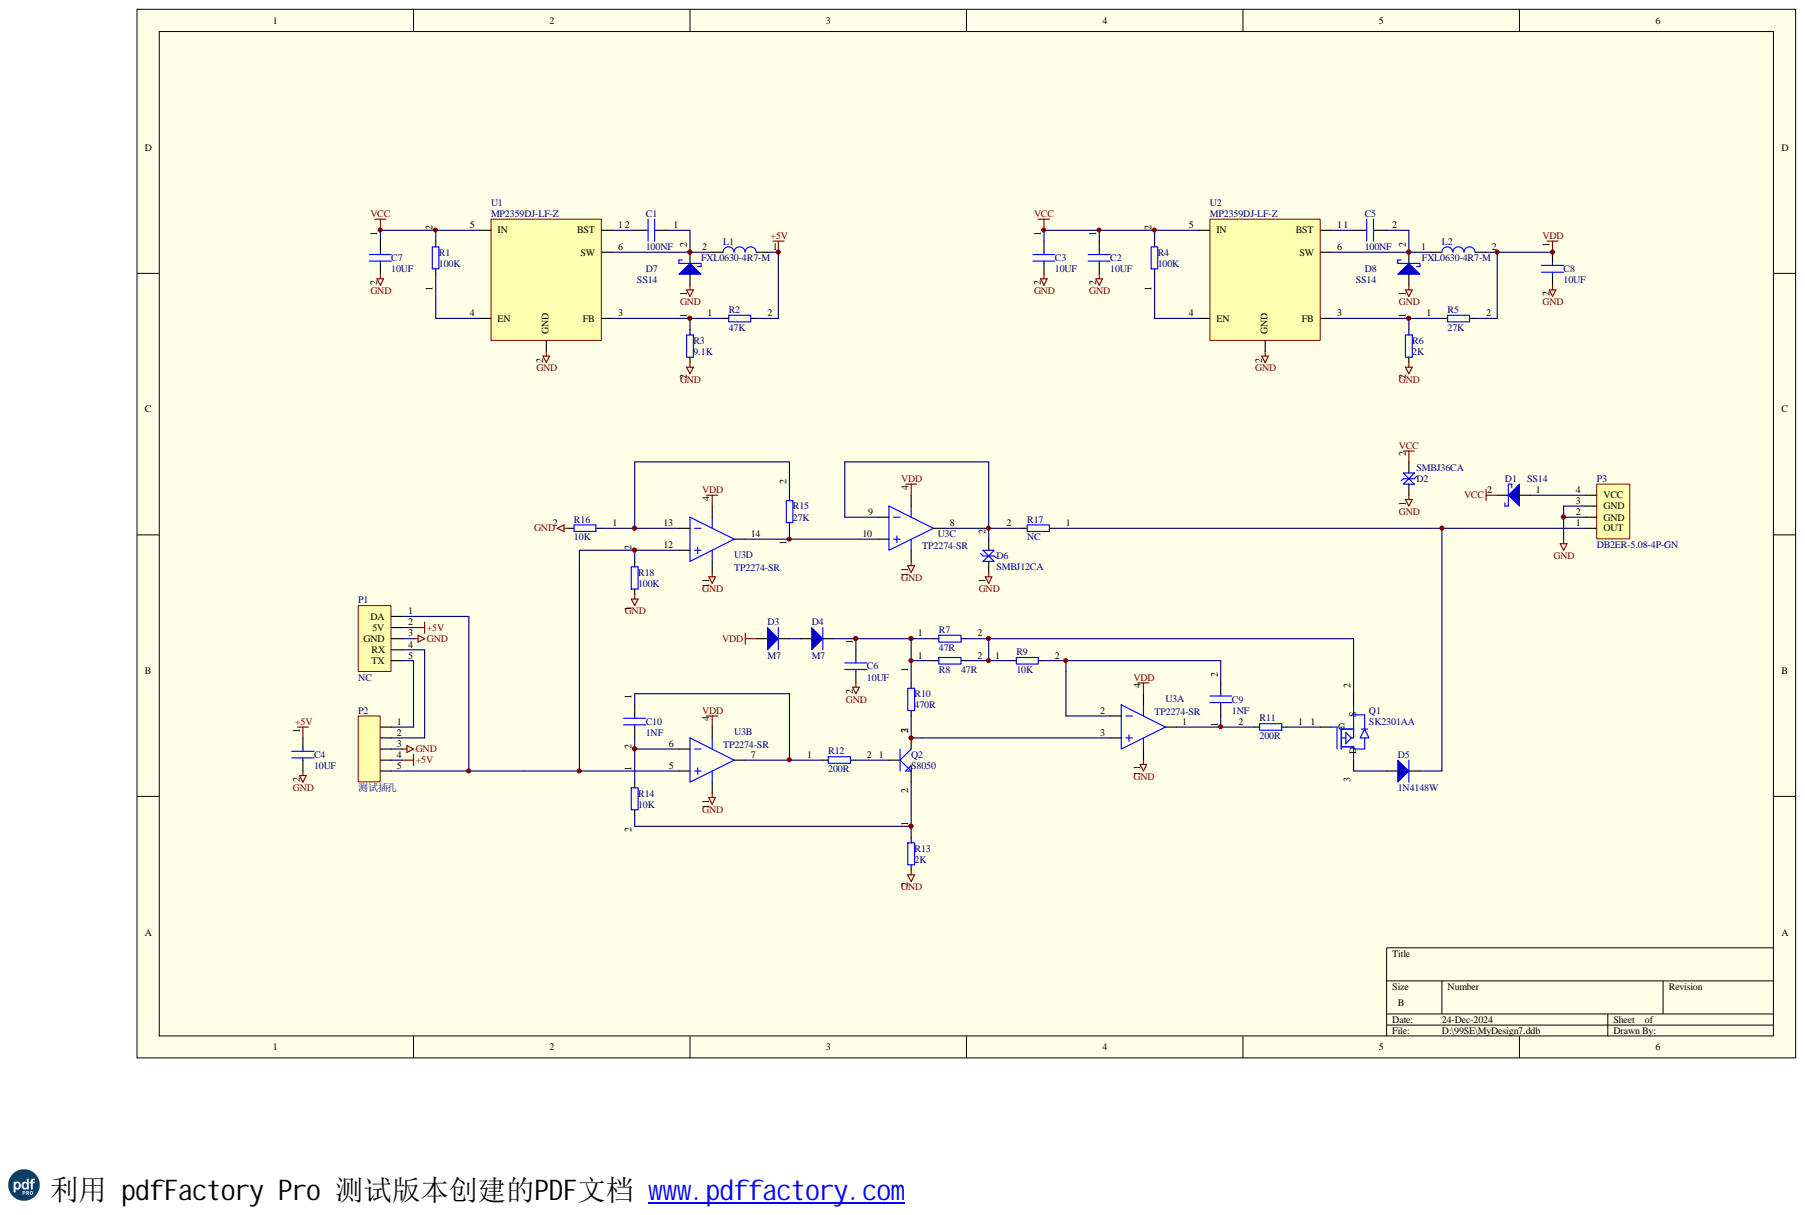
[picture p32: page 1]

利用 pdfFactory Pro 测试版本创建的PDF文档 www.pdffactory.com
