becblue/H2_transmitter_PCB/(list of files, drawings)

Other design files:
PCB文件/DARXT/DARXT.PCB
PCB文件/嘉立创新建项目/氢气传感器（已标定）模块电路/ProPrj_氢气传感器（已标定模块）_2025-02-25.epro
PCB文件/嘉立创新建项目/氢气传感器（已标定）模块电路/氢气传感器（已标定模块）.eprj
PCB文件/嘉立创新建项目/氢气传感器（已标定）模块电路/氢气传感器（已标定模块）_backup/ProPrj_氢气传感器（已标定模块）_2025-02-25.epro
PCB文件/探头底座/PCB_Project/PCB2.PcbDoc
PCB文件/探头底座/PCB_Project/PCB_Project.PrjPcb
PCB文件/探头底座/PCB_Project/Sheet1.SchDoc
